koenk/simpleclock/pcb/SimpleClock/SimpleClock/SimpleClock.kicad_pcb

## KiCad design pcb/SimpleClock/SimpleClock/SimpleClock.kicad_pcb (2019-04-24)

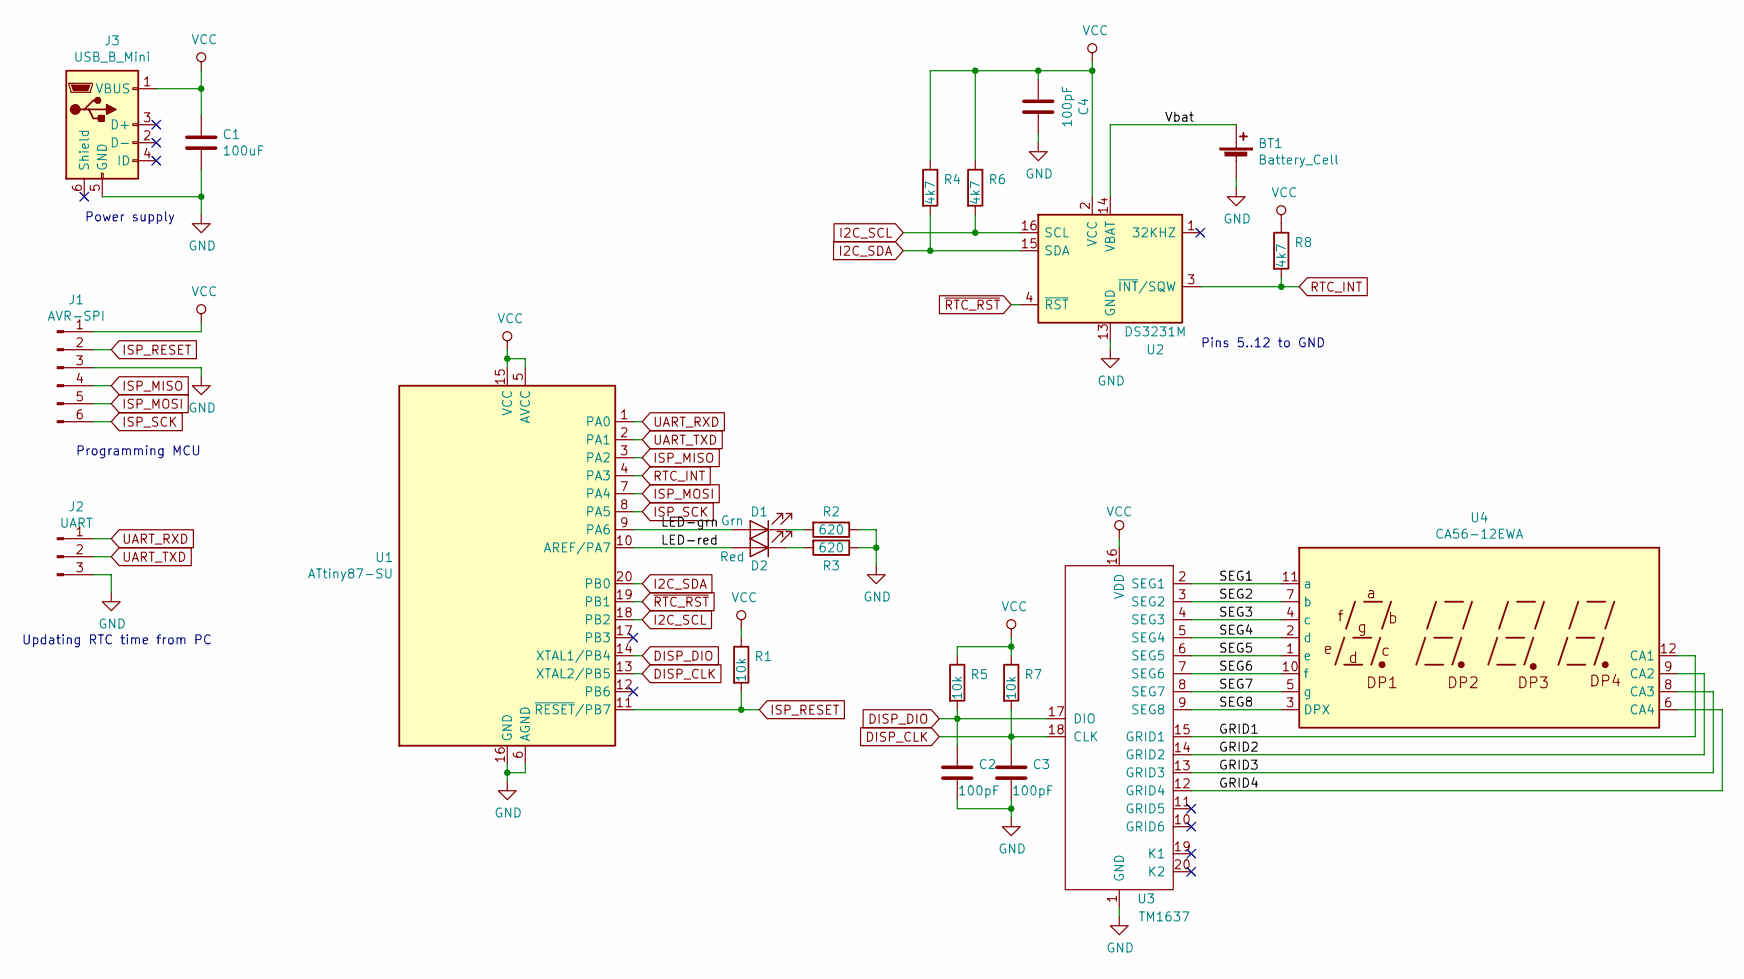
[picture p3: schematic SimpleClock.sch, Simple Clock]

Parts:
BT1: Battery_Cell; BatteryHolder_Keystone_3000_1x12mm
C1: 100uF; C_0805_2012Metric_Pad1.15x1.40mm_HandSolder
C2, C3, C4: 100pF; C_0805_2012Metric_Pad1.15x1.40mm_HandSolder
D1: Grn; LED_0603_1608Metric_Pad1.05x0.95mm_HandSolder
D2: Red; LED_0603_1608Metric_Pad1.05x0.95mm_HandSolder
J1: AVR-SPI; PinHeader_2x03_P2.54mm_Vertical
J2: UART; PinHeader_1x03_P2.54mm_Vertical
J3: USB_B_Mini; USB_Micro-B_4DIP
R1, R5, R7: 10k; R_0805_2012Metric_Pad1.15x1.40mm_HandSolder
R2, R3: 620; R_0805_2012Metric_Pad1.15x1.40mm_HandSolder
R4, R6, R8: 4k7; R_0805_2012Metric_Pad1.15x1.40mm_HandSolder
U1: ATtiny87-SU; SOIC-20W_7.5x12.8mm_P1.27mm
U2: DS3231M; SOIC-16W_7.5x10.3mm_P1.27mm
U3: TM1637; SOIC-20W_7.5x12.8mm_P1.27mm
U4: CA56-12EWA

Connections:
/GRID1: U3.15 (GRID1), U4.12 (CA1)
/GRID2: U3.14 (GRID2), U4.9 (CA2)
/GRID3: U3.13 (GRID3), U4.8 (CA3)
/GRID4: U3.12 (GRID4), U4.6 (CA4)
/LED-grn: D1.2 (A), U1.9 (PA6)
/LED-red: D2.2 (A), U1.10 (AREF/PA7)
/SEG1: U3.2 (SEG1), U4.11 (a)
/SEG2: U3.3 (SEG2), U4.7 (b)
/SEG3: U3.4 (SEG3), U4.4 (c)
/SEG4: U3.5 (SEG4), U4.2 (d)
/SEG5: U3.6 (SEG5), U4.1 (e)
/SEG6: U3.7 (SEG6), U4.10 (f)
/SEG7: U3.8 (SEG7), U4.5 (g)
/SEG8: U3.9 (SEG8), U4.3 (DPX)
/Vbat: BT1.1 (+), U2.14 (VBAT)
DISP_CLK: C3.1, R7.2, U1.13 (XTAL2/PB5), U3.18 (CLK)
DISP_DIO: C2.1, R5.2, U1.14 (XTAL1/PB4), U3.17 (DIO)
GND: BT1.2 (-), C1.2, C2.2, C3.2, C4.1, J1.3, J2.3, J3.5 (GND), R2.1, R3.1, U1.6 (AGND), U1.16 (GND), U2.5 (GND), U2.6 (GND), U2.7 (GND), U2.8 (GND), U2.9 (GND), U2.10 (GND), U2.11 (GND), U2.12 (GND), U2.13 (GND), U3.1 (GND)
I2C_SCL: R6.2, U1.18 (PB2), U2.16 (SCL)
I2C_SDA: R4.2, U1.20 (PB0), U2.15 (SDA)
ISP_MISO: J1.4, U1.3 (PA2)
ISP_MOSI: J1.5, U1.7 (PA4)
ISP_RESET: J1.2, R1.2, U1.11 (~RESET~/PB7)
ISP_SCK: J1.6, U1.8 (PA5)
unnamed: D1.1 (K), R2.2
unnamed: D2.1 (K), R3.2
RTC_INT: R8.2, U1.4 (PA3), U2.3 (~INT~/SQW)
UART_RXD: J2.1, U1.1 (PA0)
UART_TXD: J2.2, U1.2 (PA1)
VCC: C1.1, C4.2, J1.1, J3.1 (VBUS), R1.1, R4.1, R5.1, R6.1, R7.1, R8.1, U1.5 (AVCC), U1.15 (VCC), U2.2 (VCC), U3.16 (VDD)
~RTC_RST: U1.19 (PB1), U2.4 (~RST)

Notes on the sheet:
Pins 5..12 to GND
Updating RTC time from PC
Programming MCU
Power supply

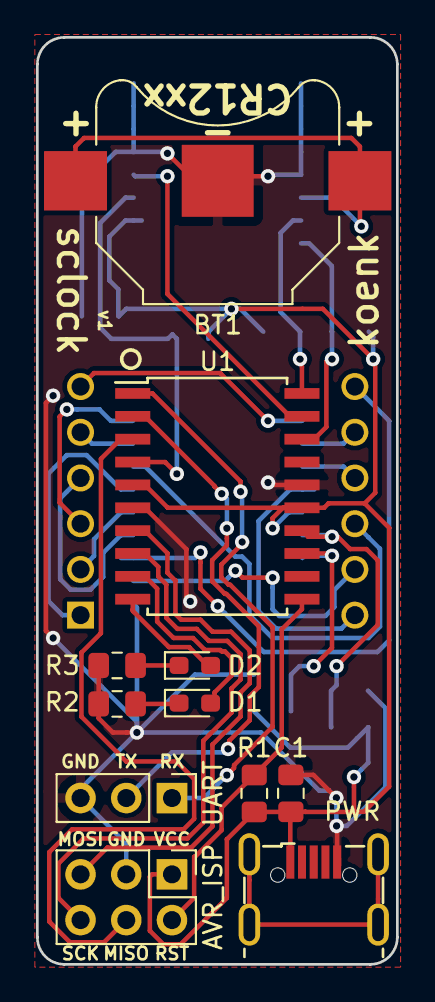
[picture p4: board SimpleClock.kicad_pcb from above]

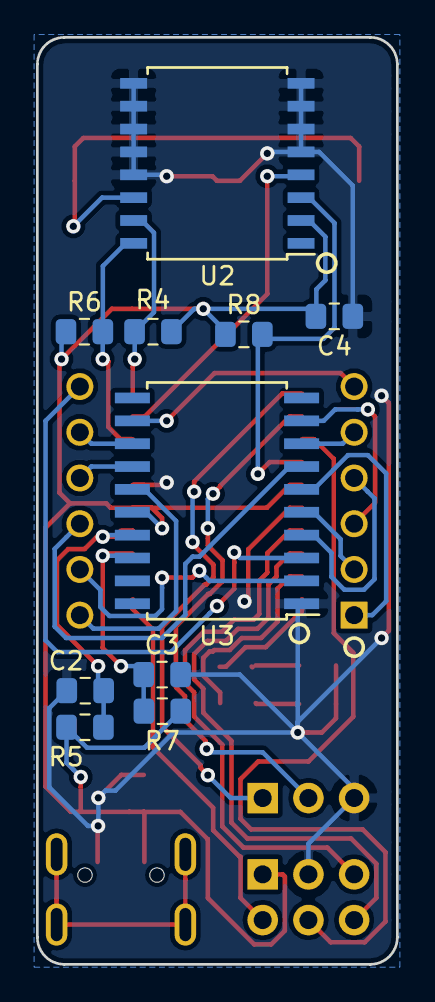
[picture p5: board SimpleClock.kicad_pcb from below]

Board: 2 copper layers, 20.0 x 51.5 mm, 22 parts (11 on the bottom side), 31 nets.
