koenk/simpleclock/(commit log)

2019-02-17 Microcontroller code for first fully functional prototype
2019-03-02 Fix colon in middle
    [display-TM1637.c, main.c]
2019-03-02 Debug blinky led mode (disabled)
2019-04-24 Import schematic and PCB design
    [SimpleClock.kicad_pcb, SimpleClock.sch]
